yessenov/SpectraMini/CREOL Documentation/Wiring/SchematicPPV3.png

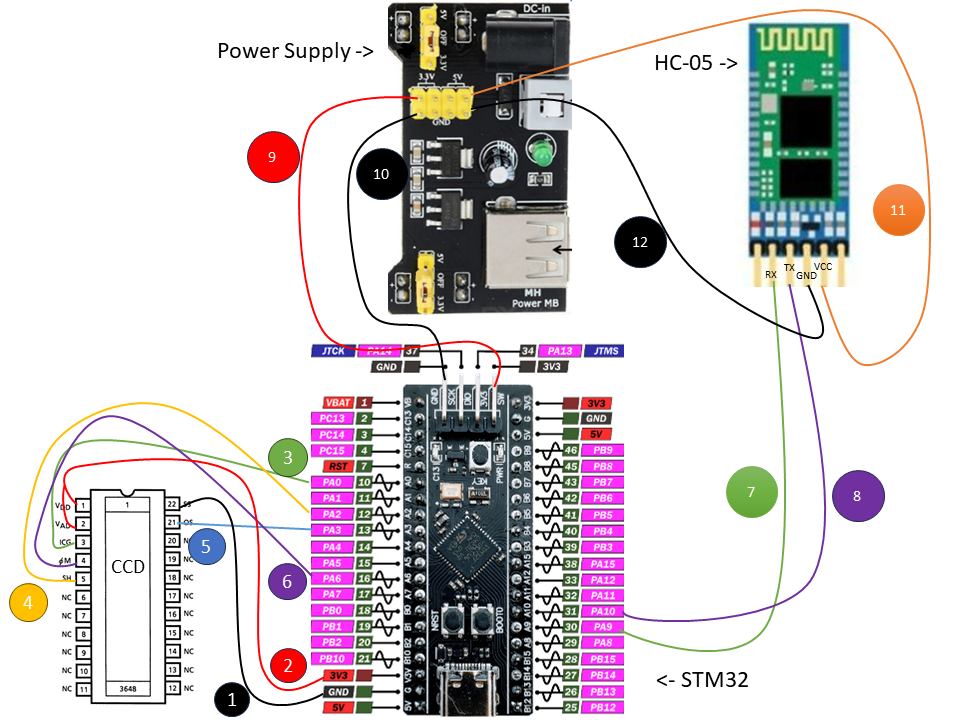
CREOL Documentation/Wiring/SchematicPPV3.png
