yessenov/SpectraMini/CREOL Documentation/Wiring/SchematicPP.pptx

Power Supply ->

HC-05 ->

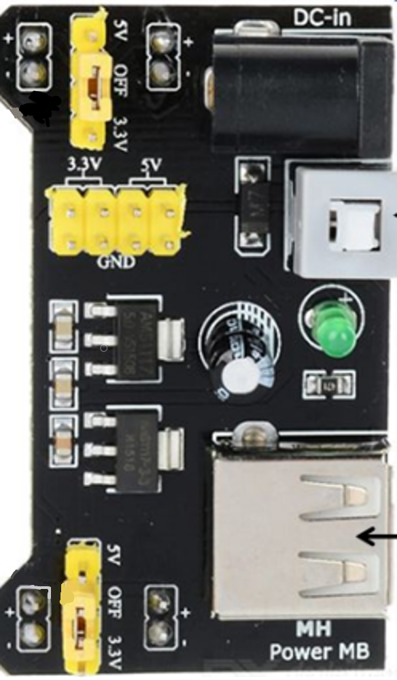
[picture p4: figure]

10

9

12

11

<- STM32

RX

VCC

TX

GND

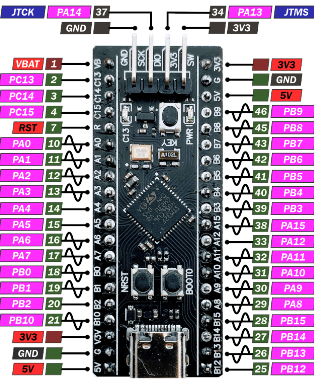
[picture p5: figure]

3

7

8

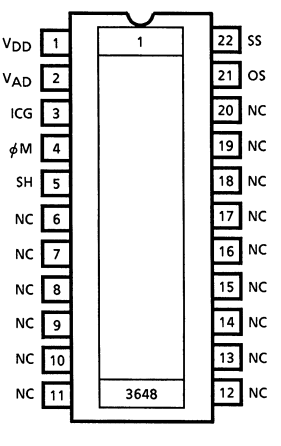
[picture p6: figure]

5

4

CCD

6

2

1
