yessenov/SpectraMini/CREOL Documentation/Wiring/SchematicPP.png

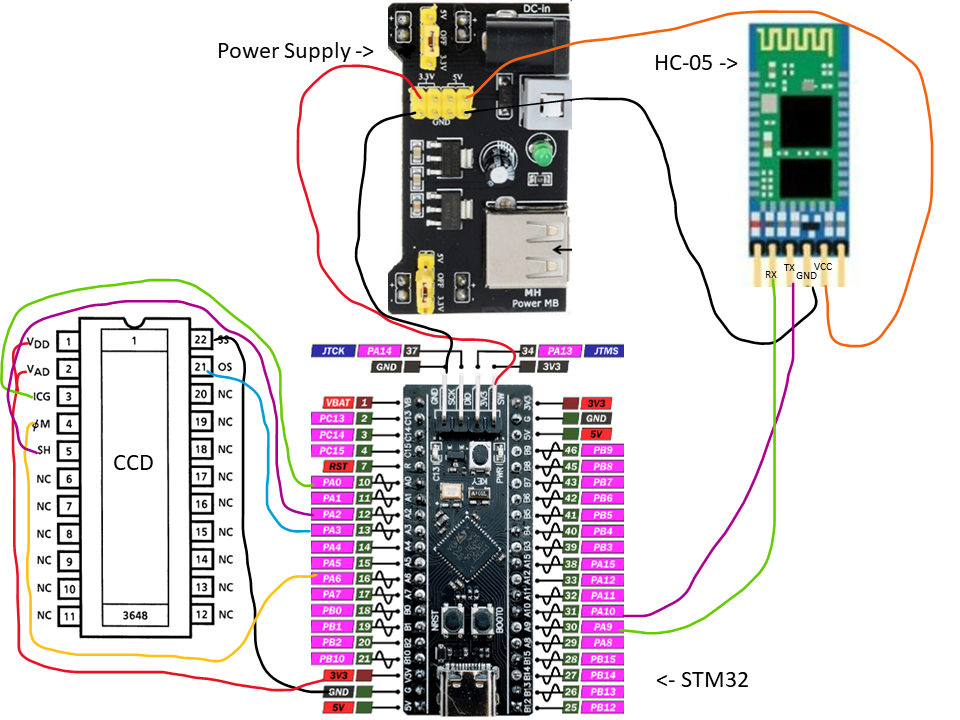
CREOL Documentation/Wiring/SchematicPP.png
