yessenov/SpectraMini/CREOL Documentation/Wiring/SpectraMini Rough Sketch.jpg

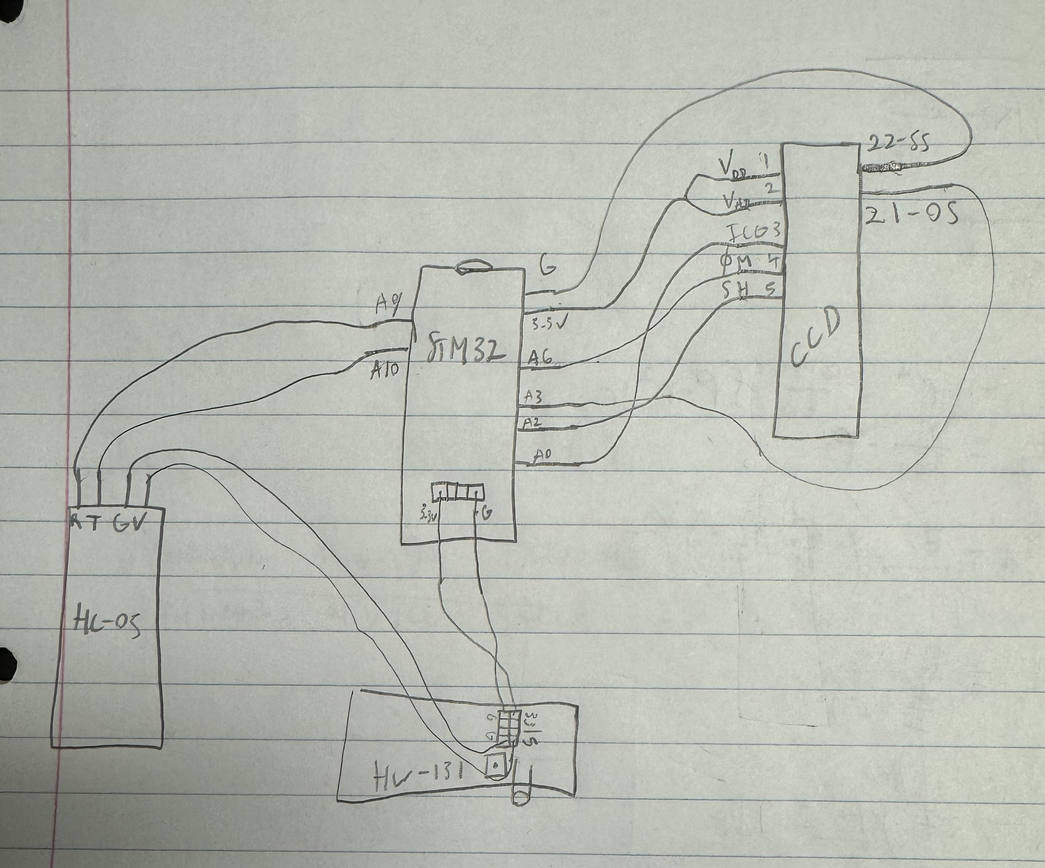
CREOL Documentation/Wiring/SpectraMini Rough Sketch.jpg
