yessenov/SpectraMini/CREOL Documentation/Wiring/Power MB.png

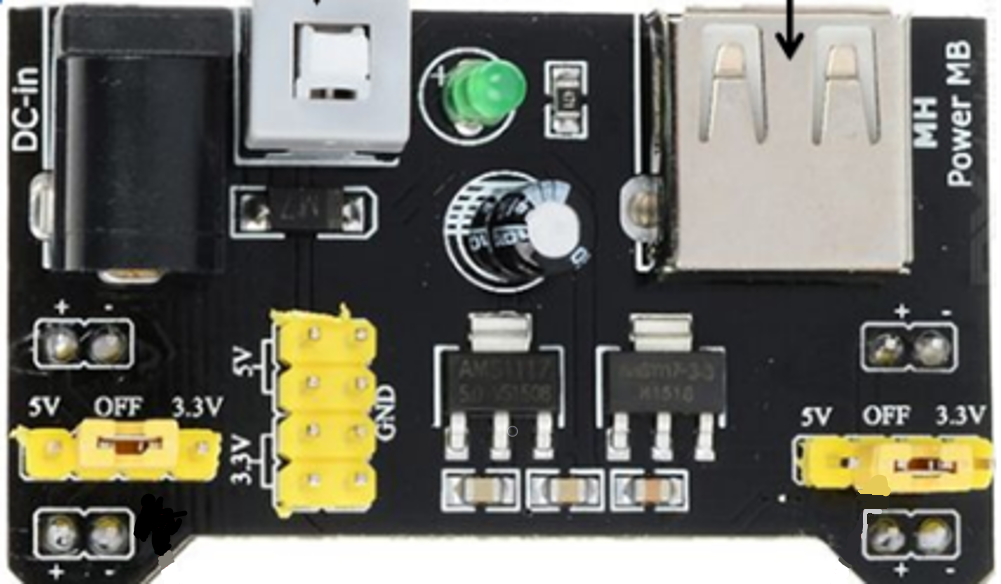
CREOL Documentation/Wiring/Power MB.png
