yessenov/SpectraMini/CREOL Documentation/STM32 Code/CCD Mini Export/CCD Mini/Core/Inc/main.h

#define ICG_Pin GPIO_PIN_0
#define ICG_GPIO_Port GPIOA
#define SH_Pin GPIO_PIN_2
#define SH_GPIO_Port GPIOA
#define Master_Clock_Pin GPIO_PIN_6
#define Master_Clock_GPIO_Port GPIOA
